mikaelsundin/dram_fun/README.md

# dram_fun
Arduino with 512kbyte DRAM memory connected.

Proof of concept. Will use all GPIO on Arduino Nano V3. 

Eagle PCB adapter for Arduino Nano V3. 
Single sided with one jumper. 

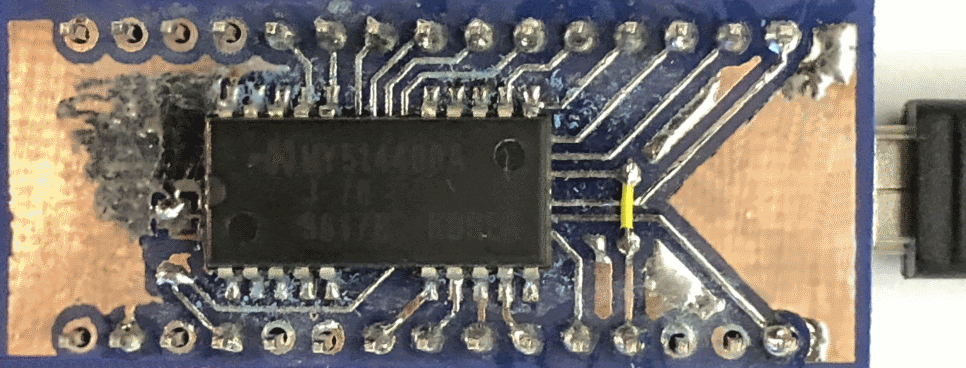
[picture p1: doc/pcb_photo.png]
Image of PCB adapter
