mikaelsundin/dram_fun/cad/dram_arduino_adapter.brd

## EAGLE design cad/dram_arduino_adapter.brd (2020-05-10)

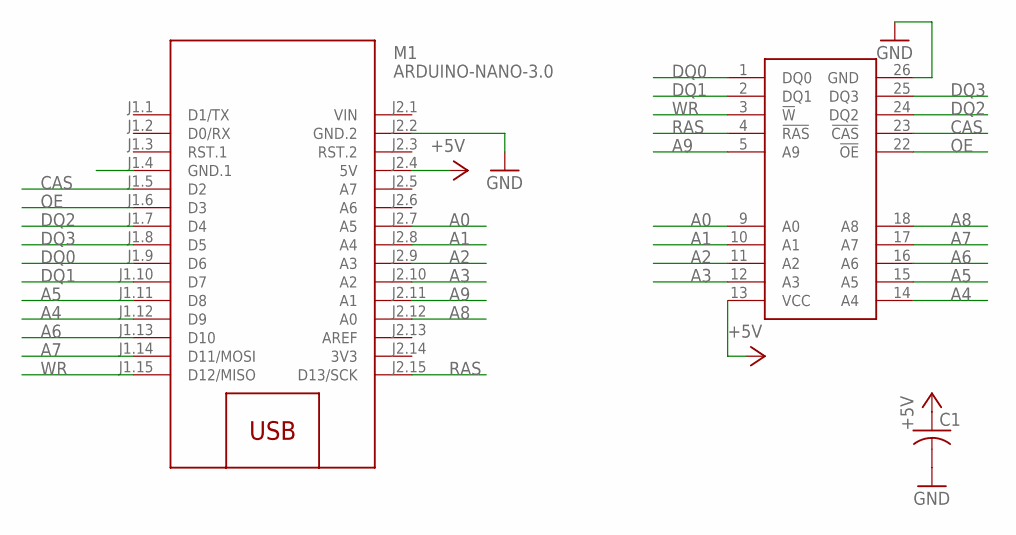
[picture p2: schematic dram_arduino_adapter.sch]

Parts:
C1: C-USC1206; C1206
M1: ARDUINO-NANO-3.0
U$1: HY514400A

Connections:
3V3: M1.J2.14 (3V3)
+5V: C1.1, M1.J2.4 (5V), U$1.13 (VCC)
A0: M1.J2.7 (A5), U$1.9 (A0)
A1: M1.J2.8 (A4), U$1.10 (A1)
A2: M1.J2.9 (A3), U$1.11 (A2)
A3: M1.J2.10 (A2), U$1.12 (A3)
A4: M1.J1.12 (D9), U$1.14 (A4)
A5: M1.J1.11 (D8), U$1.15 (A5)
A6: M1.J1.13 (D10), U$1.16 (A6)
A7: M1.J1.14 (D11/MOSI), U$1.17 (A7)
A8: M1.J2.12 (A0), U$1.18 (A8)
A9: M1.J2.11 (A1), U$1.5 (A9)
CAS: M1.J1.5 (D2), U$1.23 (!CAS!)
DQ0: M1.J1.9 (D6), U$1.1 (DQ0)
DQ1: M1.J1.10 (D7), U$1.2 (DQ1)
DQ2: M1.J1.7 (D4), U$1.24 (DQ2)
DQ3: M1.J1.8 (D5), U$1.25 (DQ3)
GND: C1.2, M1.J2.2 (GND.2), U$1.26 (GND)
OE: M1.J1.6 (D3), U$1.22 (!OE!)
RAS: M1.J2.15 (D13/SCK), U$1.4 (!RAS!)
VIN: M1.J2.1 (VIN)
WR: M1.J1.15 (D12/MISO), U$1.3 (!W!)

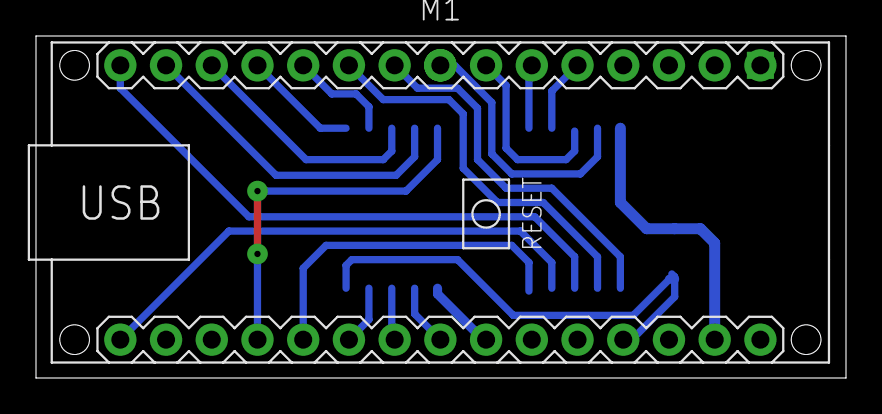
[picture p3: board dram_arduino_adapter.brd from above]

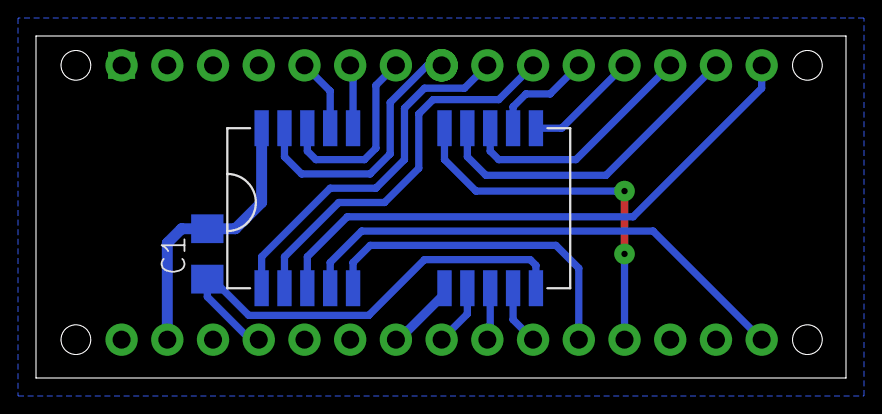
[picture p4: board dram_arduino_adapter.brd from below]

Board: 2 copper layers, 45.0 x 19.0 mm, 3 parts (2 on the bottom side), 20 nets.
