mikaelsundin/dram_fun/(commit log)

2020-05-10 Added code, dram_arduino_adapter pcb and some datasheet on HY514400A 5V 1Mx4 DRAM chip.
    [dram_arduino_adapter.brd, dram_arduino_adapter.sch]
2020-05-10 Addded PCB photo.
